glennji/ibm-jx-5511-pc/dDSC_1564.jpg

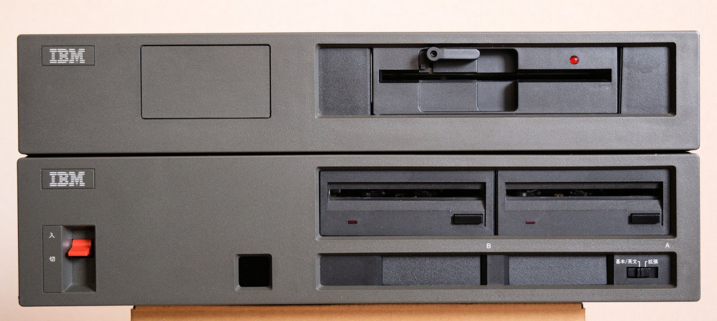
dDSC_1564.jpg
