glennji/ibm-jx-5511-pc/preview_dvd_fascia.png

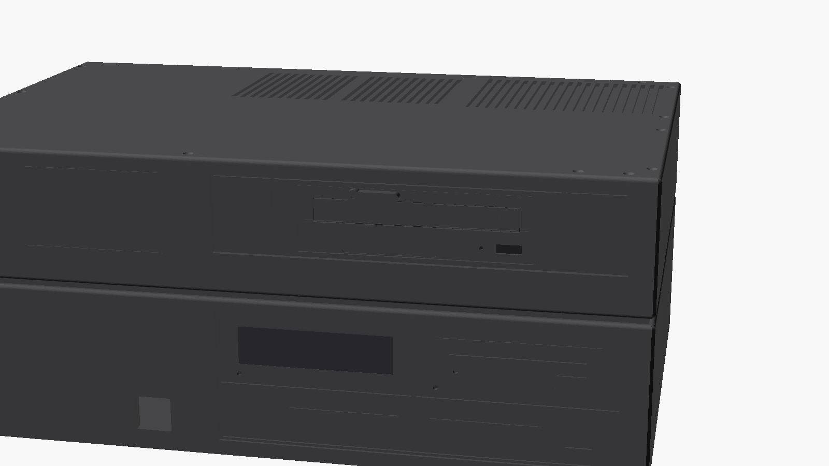
preview_dvd_fascia.png
