glennji/ibm-jx-5511-pc/preview_front.png

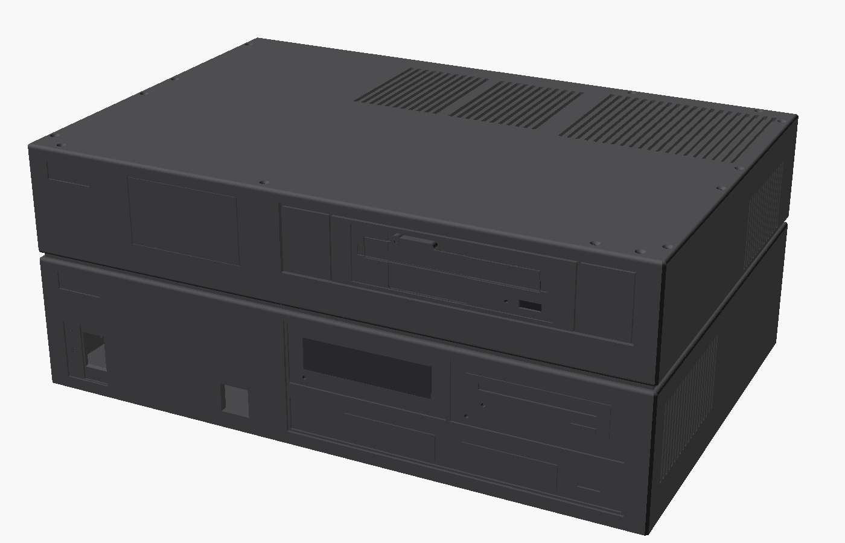
preview_front.png
