glennji/ibm-jx-5511-pc/preview_front_flat.png

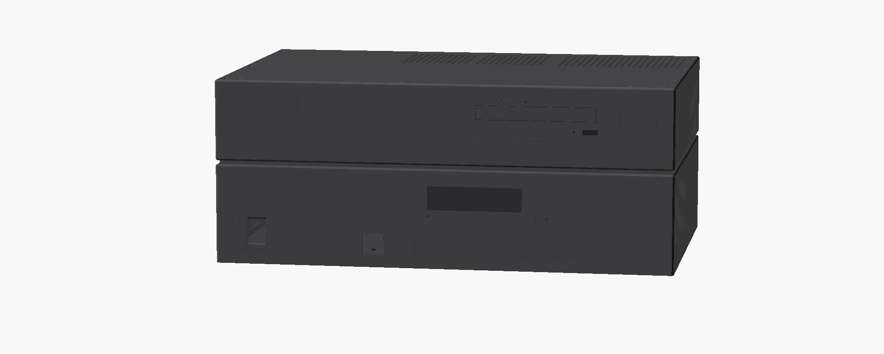
preview_front_flat.png
