glennji/ibm-jx-5511-pc/preview_labels_all.png

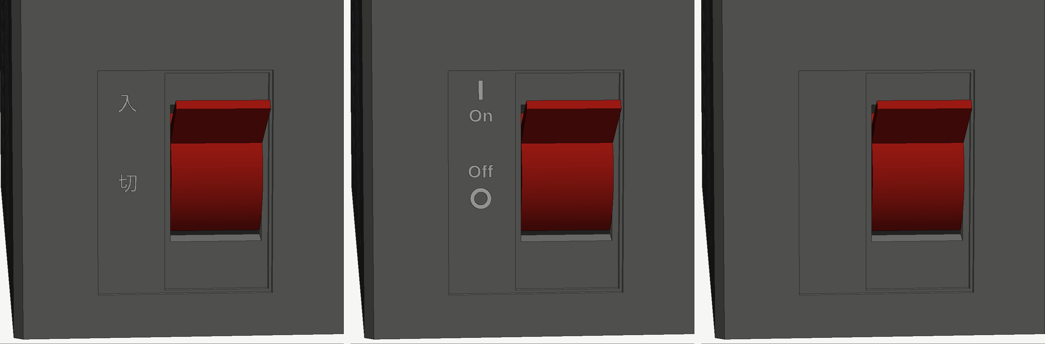
preview_labels_all.png
