glennji/ibm-jx-5511-pc/preview_labels_BLANK.png

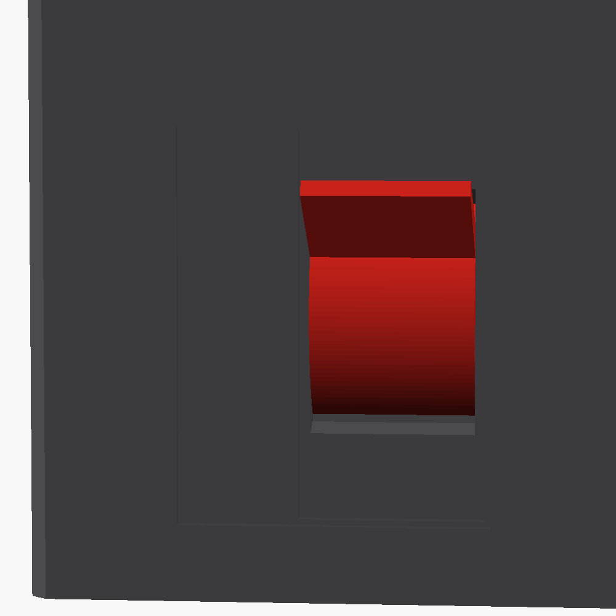
preview_labels_BLANK.png
