glennji/ibm-jx-5511-pc/preview_labels_EN.png

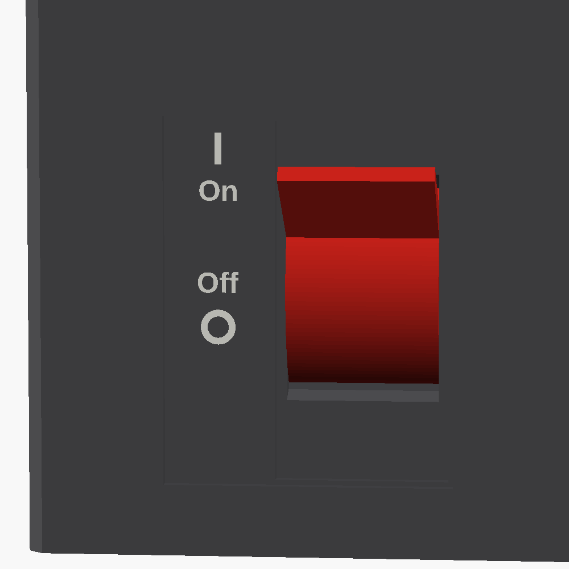
preview_labels_EN.png
