glennji/ibm-jx-5511-pc/preview_open.png

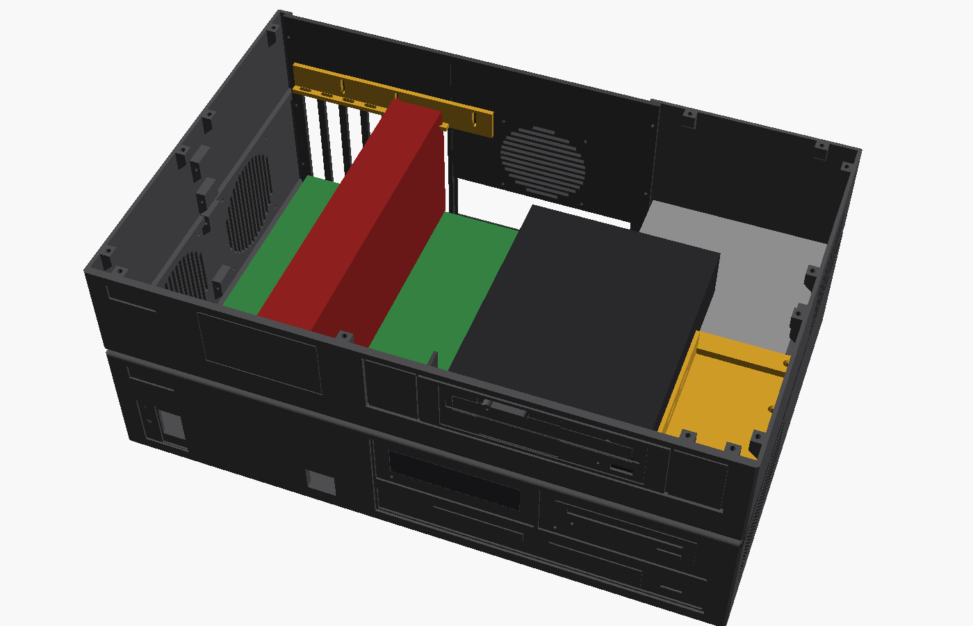
preview_open.png
