glennji/ibm-jx-5511-pc/preview_power_front.png

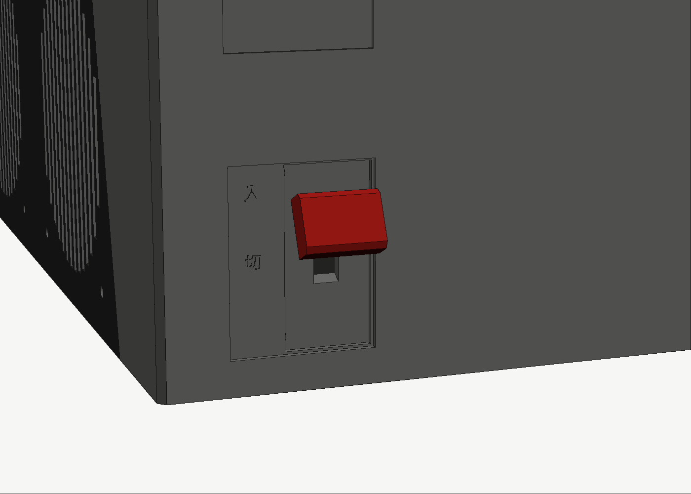
preview_power_front.png
