glennji/ibm-jx-5511-pc/preview_power_inside.png

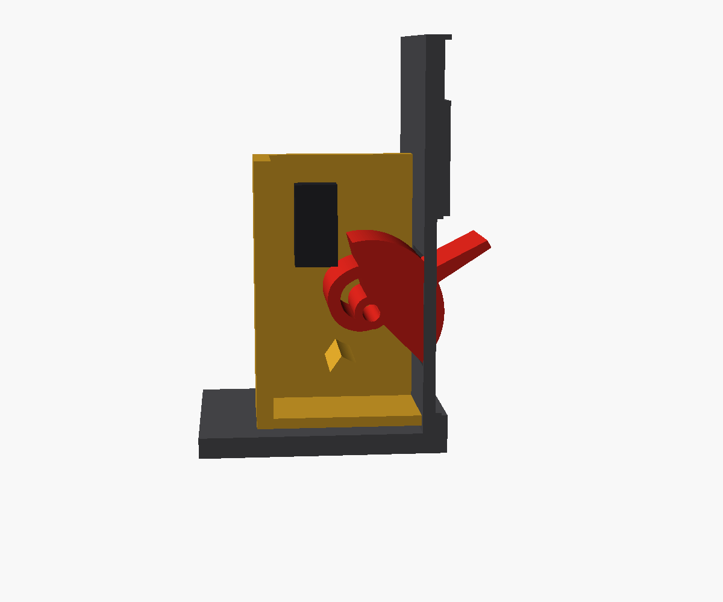
preview_power_inside.png
