glennji/ibm-jx-5511-pc/preview_power_off.png

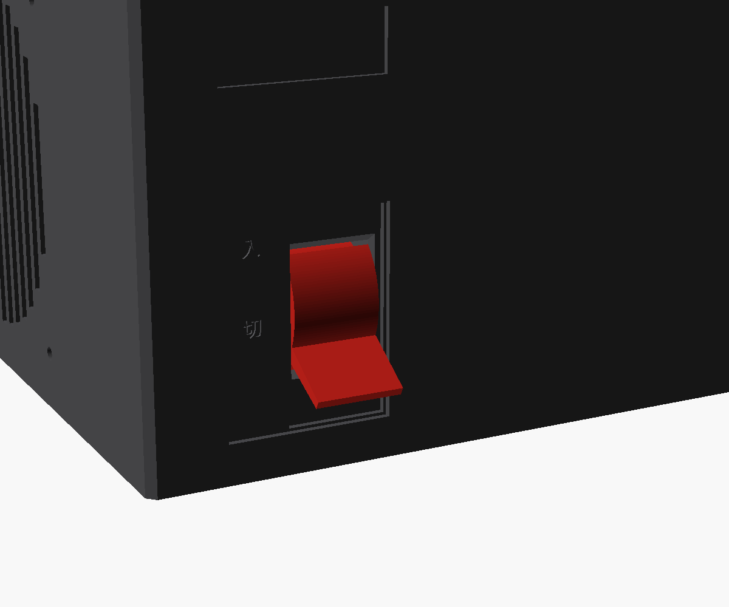
preview_power_off.png
