glennji/ibm-jx-5511-pc/preview_rear.png

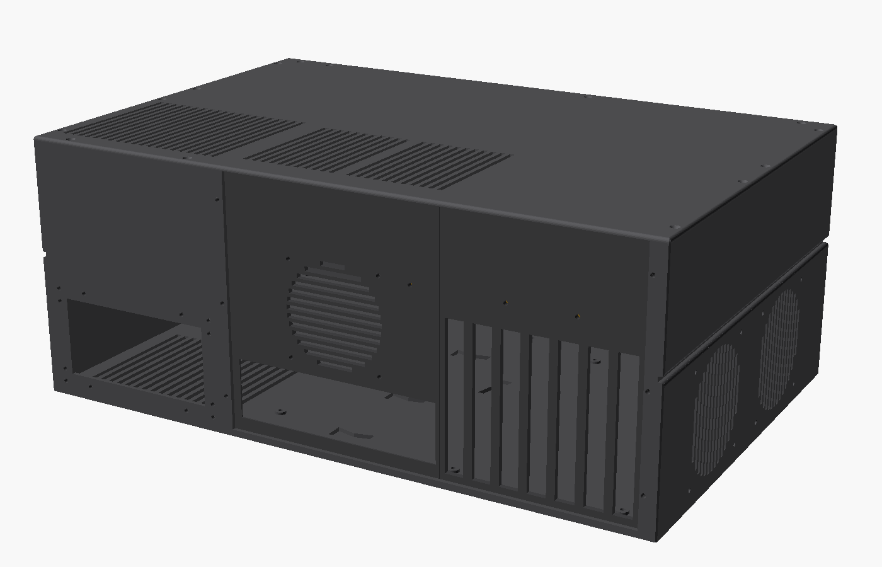
preview_rear.png
