glennji/ibm-jx-5511-pc/3mf/_assembly_open_preview.3mf

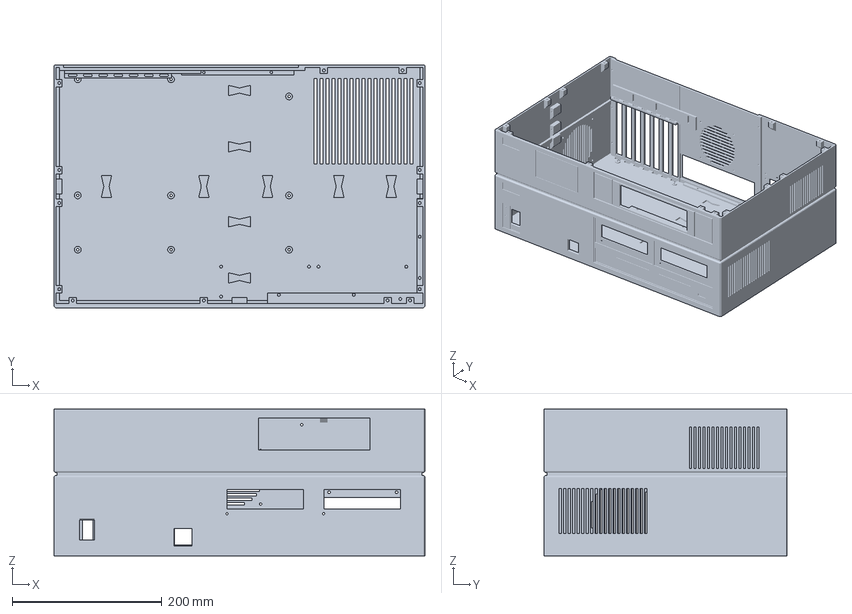
[picture p14: CAD file, 2026-11-01]
3mf/_assembly_open_preview.3mf
495.0 x 324.0 x 196.0 mm
