glennji/ibm-jx-5511-pc/3mf/rear_io_panel.3mf

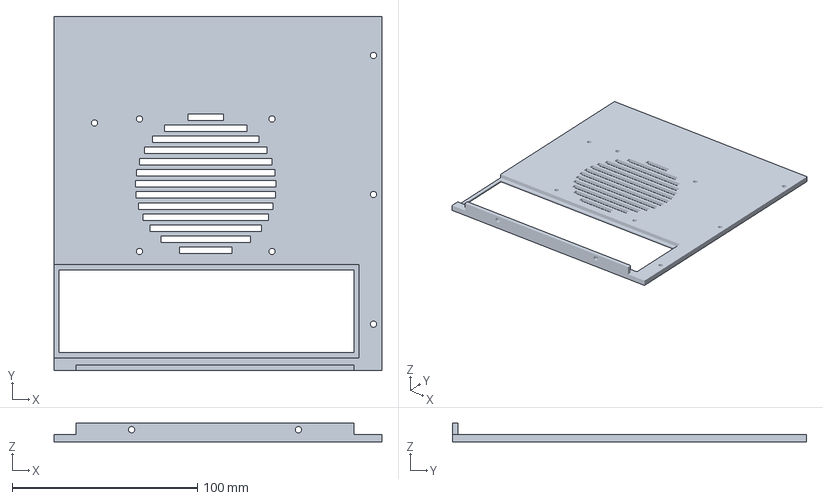
[picture p16: CAD file, 2026-11-01]
3mf/rear_io_panel.3mf
176.8 x 191.0 x 10.0 mm
