glennji/ibm-jx-5511-pc/3mf/lid_rear_right.3mf

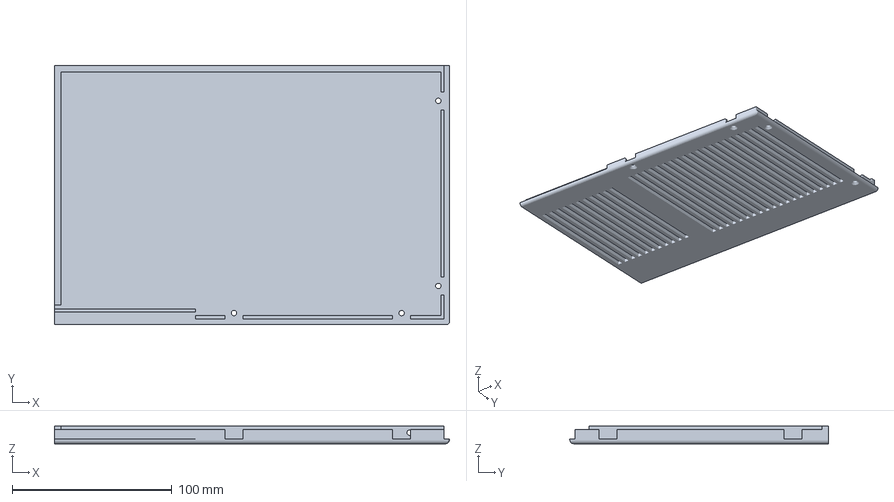
[picture p17: CAD file, 2026-11-01]
3mf/lid_rear_right.3mf
247.5 x 162.0 x 11.0 mm
