glennji/ibm-jx-5511-pc/3mf/dvd_fascia_tray.3mf

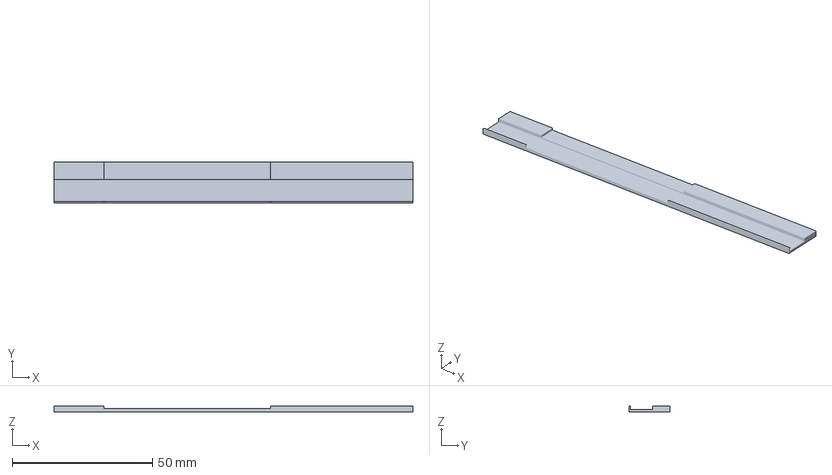
[picture p21: CAD file, 2026-11-01]
3mf/dvd_fascia_tray.3mf
128.0 x 14.5 x 2.00 mm
