glennji/ibm-jx-5511-pc/3mf/base_front_left_EN.3mf

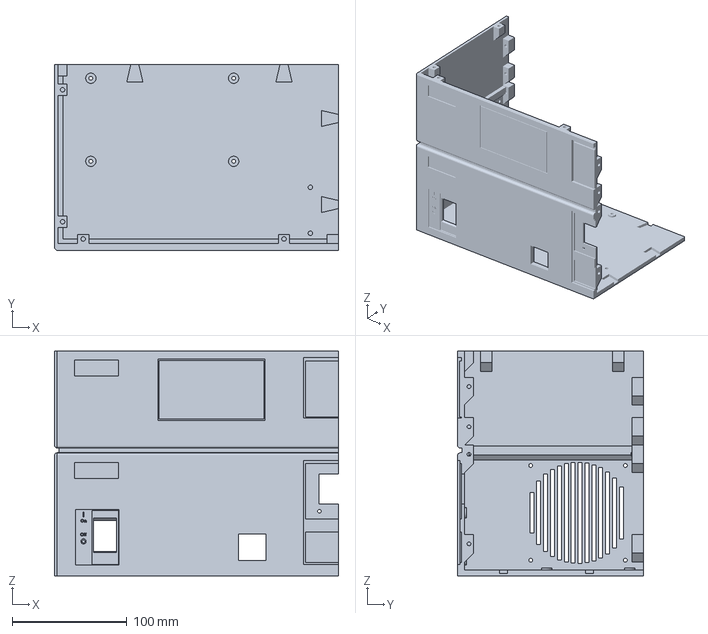
[picture p22: CAD file, 2026-11-01]
3mf/base_front_left_EN.3mf
247.5 x 162.0 x 196.0 mm
