glennji/ibm-jx-5511-pc/3mf/bay_blank_clip_x2.3mf

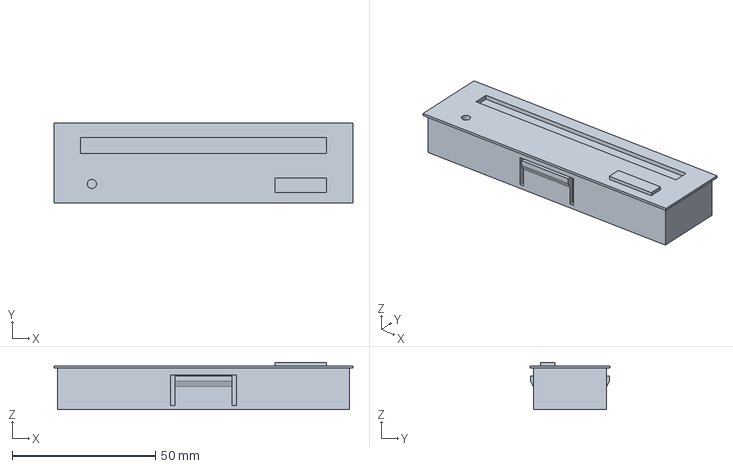
[picture p23: CAD file, 2026-11-01]
3mf/bay_blank_clip_x2.3mf
104.2 x 28.0 x 16.5 mm
