glennji/ibm-jx-5511-pc/3mf/fit_template_left.3mf

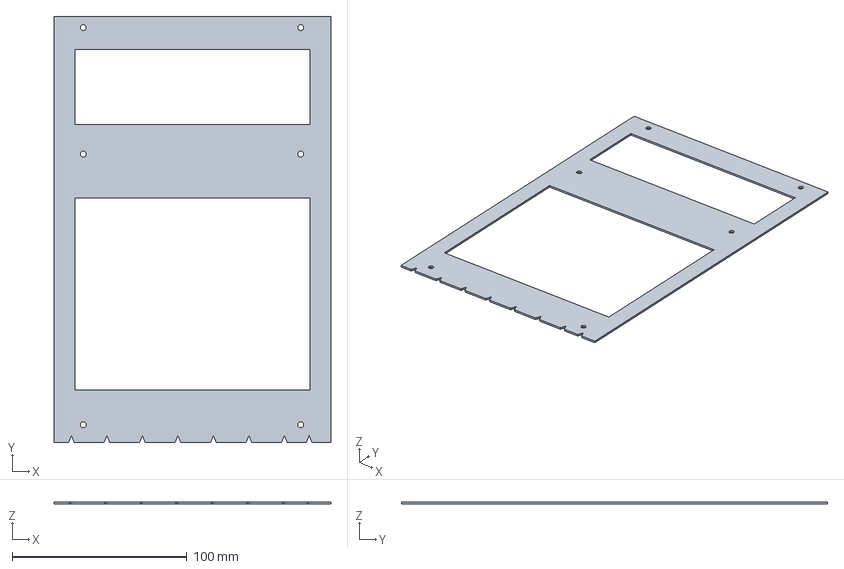
[picture p24: CAD file, 2026-11-01]
3mf/fit_template_left.3mf
158.4 x 243.8 x 1.20 mm
