glennji/ibm-jx-5511-pc/3mf/bay_cage_35_x2.3mf

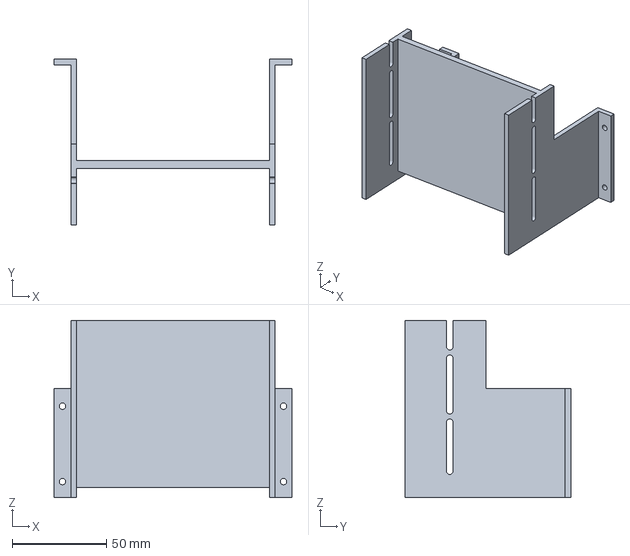
[picture p25: CAD file, 2026-11-01]
3mf/bay_cage_35_x2.3mf
126.2 x 87.9 x 94.0 mm
