glennji/ibm-jx-5511-pc/3mf/power_switch_frame.3mf

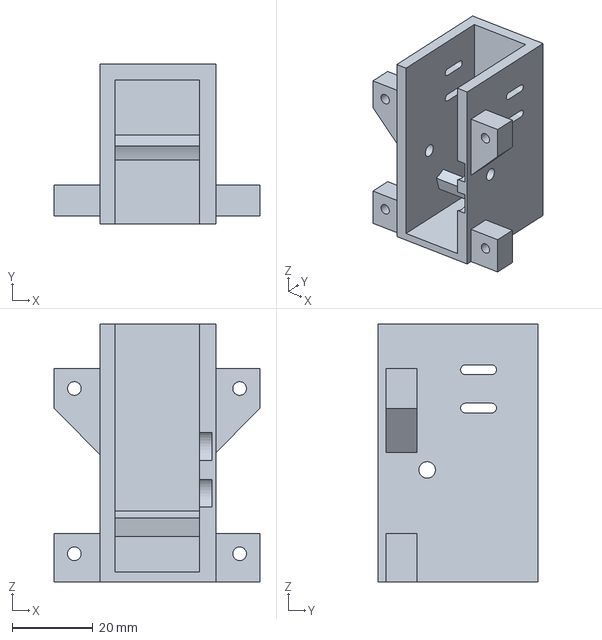
[picture p26: CAD file, 2026-11-01]
3mf/power_switch_frame.3mf
51.0 x 39.7 x 64.0 mm
