glennji/ibm-jx-5511-pc/3mf/foot_x6.3mf

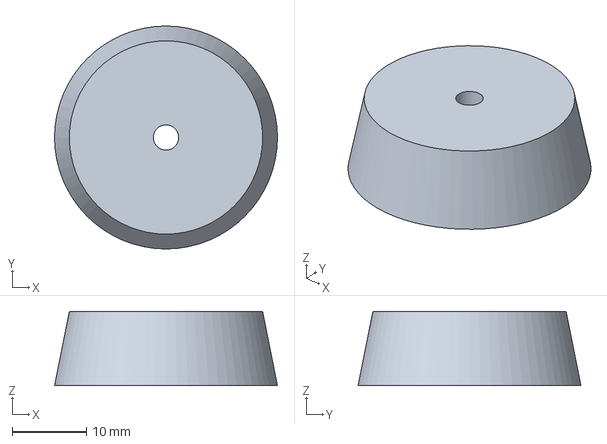
[picture p27: CAD file, 2026-11-01]
3mf/foot_x6.3mf
30.0 x 30.0 x 10.0 mm
