glennji/ibm-jx-5511-pc/3mf/rear_slot_panel.3mf

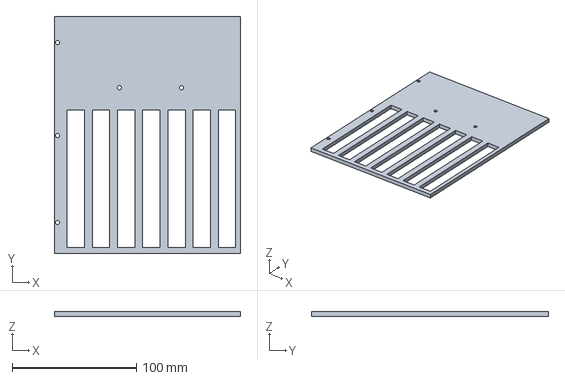
[picture p28: CAD file, 2026-11-01]
3mf/rear_slot_panel.3mf
150.2 x 191.0 x 4.00 mm
