glennji/ibm-jx-5511-pc/3mf/labels_JP_inlay.3mf

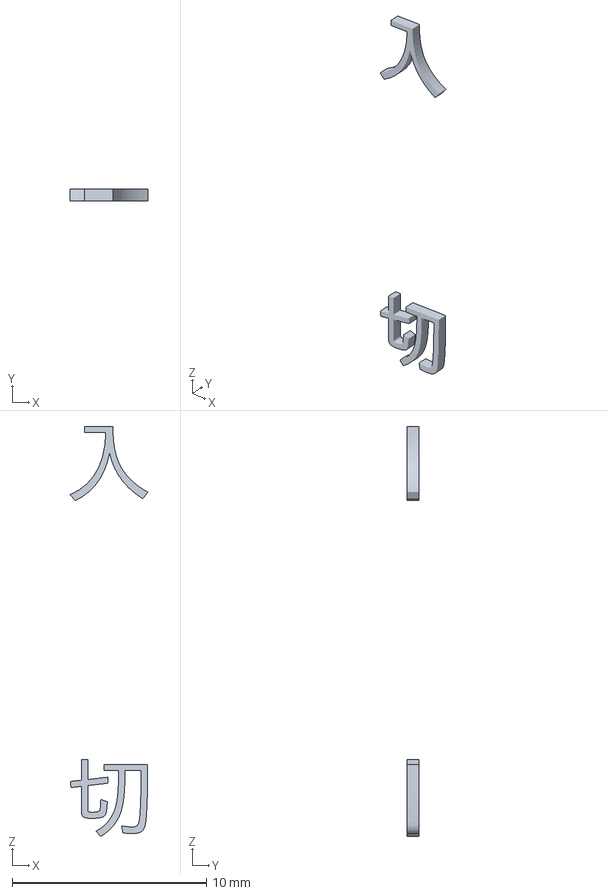
[picture p29: CAD file, 2026-11-01]
3mf/labels_JP_inlay.3mf
4.00 x 0.6 x 21.1 mm
