glennji/ibm-jx-5511-pc/3mf/butterfly_key_x9.3mf

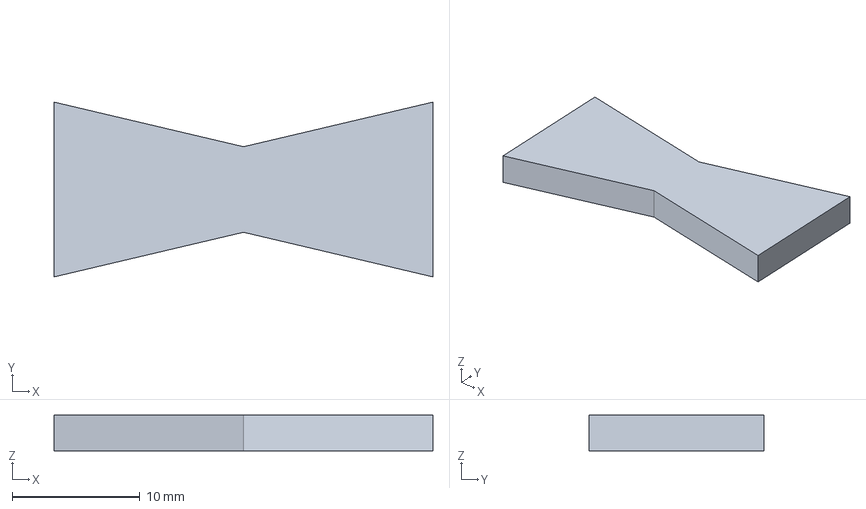
[picture p30: CAD file, 2026-11-01]
3mf/butterfly_key_x9.3mf
29.7 x 13.7 x 2.80 mm
