glennji/ibm-jx-5511-pc/3mf/labels_EN_inlay.3mf

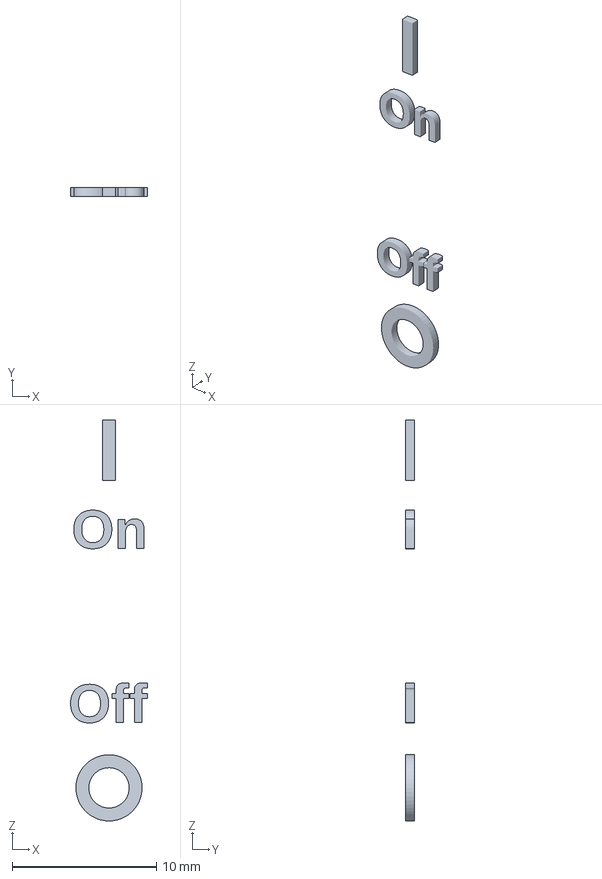
[picture p31: CAD file, 2026-11-01]
3mf/labels_EN_inlay.3mf
5.34 x 0.6 x 27.8 mm
