glennji/ibm-jx-5511-pc/3mf/lid_front_left.3mf

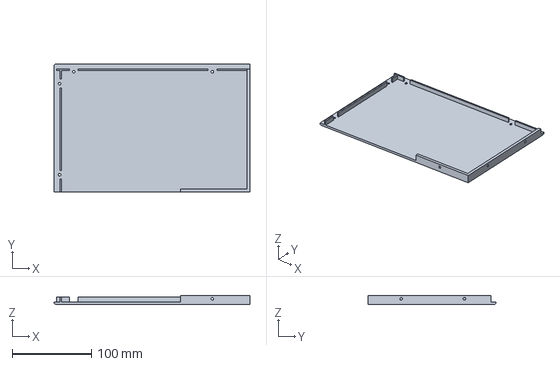
[picture p32: CAD file, 2026-11-01]
3mf/lid_front_left.3mf
247.5 x 162.0 x 11.0 mm
