glennji/ibm-jx-5511-pc/3mf/dvd_fascia_frame.3mf

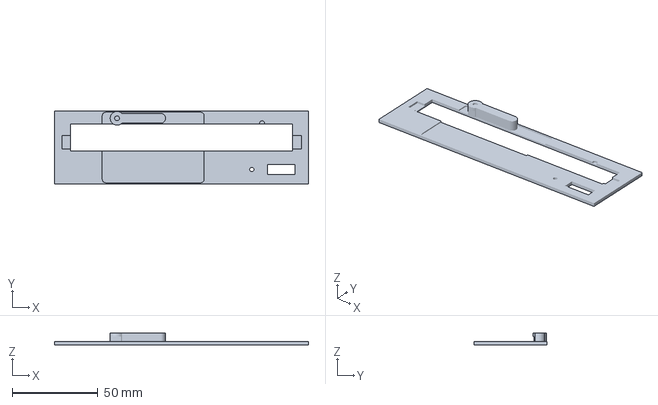
[picture p33: CAD file, 2026-11-01]
3mf/dvd_fascia_frame.3mf
148.0 x 42.3 x 7.00 mm
