glennji/ibm-jx-5511-pc/3mf/badge_plate_x2.3mf

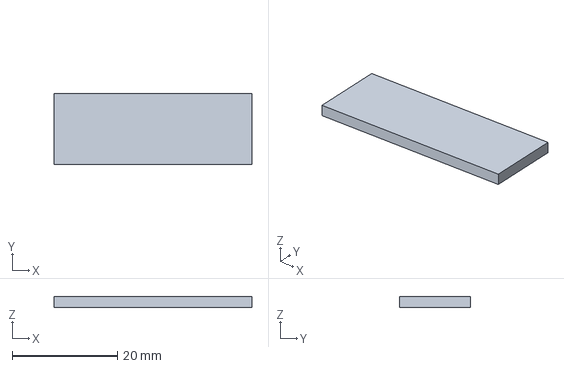
[picture p34: CAD file, 2026-11-01]
3mf/badge_plate_x2.3mf
37.7 x 13.6 x 2.00 mm
