glennji/ibm-jx-5511-pc/3mf/bracket_rail.3mf

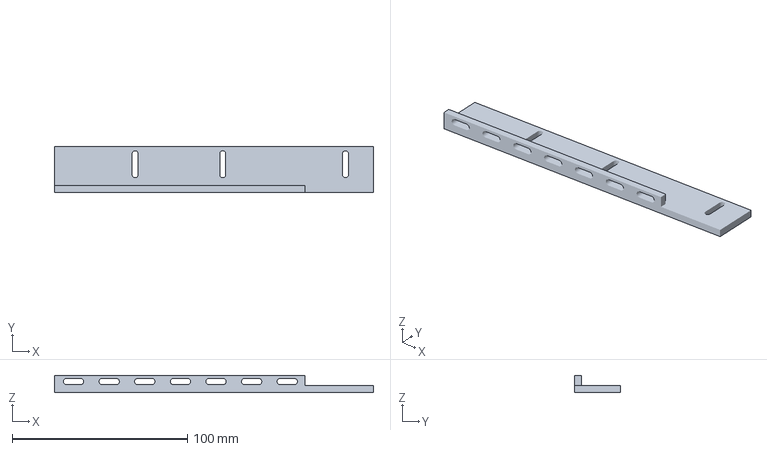
[picture p36: CAD file, 2026-11-01]
3mf/bracket_rail.3mf
182.0 x 26.0 x 9.80 mm
