glennji/ibm-jx-5511-pc/3mf/dvd_shelf.3mf

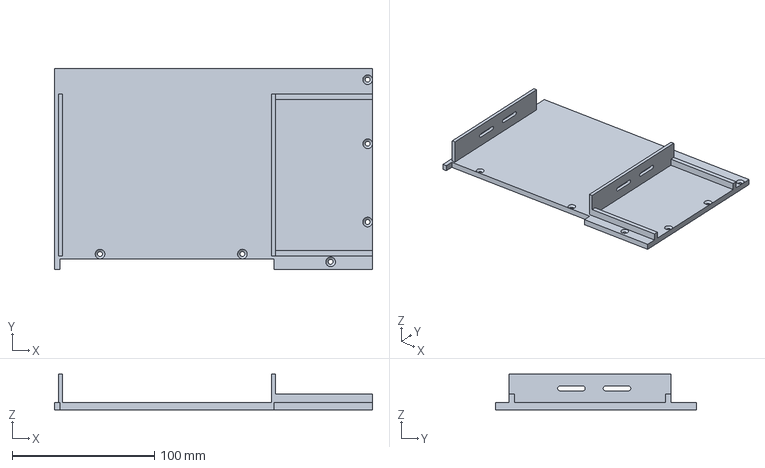
[picture p38: CAD file, 2026-11-01]
3mf/dvd_shelf.3mf
223.4 x 141.5 x 25.0 mm
