glennji/ibm-jx-5511-pc/(list of files, cad)

Other CAD files:
3mf/base_front_left_JP.3mf
3mf/base_front_left_BLANK.3mf
3mf/fit_template_right.3mf
stl/_assembly_open_preview.stl
stl/_assembly_preview.stl
stl/badge_plate_x2.stl
stl/base_front_left_BLANK.stl
stl/base_front_left_EN.stl
stl/base_front_left_JP.stl
stl/base_front_right.stl
stl/base_rear_left.stl
stl/base_rear_right.stl
stl/bay_blank_clip_x2.stl
stl/bay_cage_35_x2.stl
stl/bracket_rail.stl
stl/butterfly_key_x9.stl
stl/dvd_fascia_frame.stl
stl/dvd_fascia_tray.stl
stl/dvd_shelf.stl
stl/fit_template_left.stl
stl/fit_template_right.stl
stl/foot_x6.stl
stl/labels_EN_inlay.stl
stl/labels_JP_inlay.stl
stl/lid_front_left.stl
stl/lid_front_right.stl
stl/lid_rear_left.stl
stl/lid_rear_right.stl
stl/power_switch_frame.stl
stl/rear_io_panel.stl
stl/rear_slot_panel.stl
