glennji/ibm-jx-5511-pc/(commit log)

2026-10-18 feat: initial commit
    Printable case for LARPing as an IBM JX 5511 owner i.e. nostalgia level
    9. Still very much a work in progress, but I'm going to go order some
    charcoal PETG!
    [_assembly_preview.stl, badge_plate_x2.stl, base_front_left.stl, base_front_right.stl, base_rear_left.stl, base_rear_right.stl, bracket_rail.stl, butterfly_key_x9.stl]
2026-10-20 Tweaks
    Adjust ratio and groove depth to make it closer to the JX stack. Make
    the drive-slots functional.
    [_assembly_preview.stl, badge_plate_x2.stl, base_front_left.stl, base_front_right.stl, base_rear_left.stl, base_rear_right.stl, bay_blank_clip_x2.stl, bay_cage_35_x2.stl]
2026-10-26 Openscad (#1)
    * Port the case model to OpenSCAD
    jx_case.scad replaces jx_case.py, converted line for line; every part
    matches the previous STLs in volume and bounding box. build.py renders
    the parts and drops them onto the bed, fitcheck.py checks clearances as
    OpenSCAD intersections, and render.py exports previews from the scenes
    in render.scad. The scripts need only the Python standard library.
    Label parts are not written when the label font is missing, since a
    fallback font can cut missing-glyph boxes into the face. Previews use a
    charcoal case colour (CASE_COLOUR in render.scad).
    * Remove STLs left over from earlier designs
    * Round the lid's top edge and the groove lips
    The lid's top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
    [_assembly_open_preview.stl, _assembly_preview.stl, badge_plate_x2.stl, base_front_left.stl, base_front_left_BLANK.stl, base_front_left_EN.stl, base_front_left_JP.stl, base_front_right.stl]
2026-11-01 Add 3MF export and support the OpenSCAD snapshot AppImage (#2)
    * Add 3MF export and support the OpenSCAD snapshot AppImage
    - build.py --3mf writes every part as 3MF into ./3mf (same bed placement,
    label-inlay pairing and size report as the STL build). The writer is in
    scadtools.write_3mf and uses only the standard library.
    - Add the generated 3mf/ files alongside stl/.
    - Older OpenSCAD snapshots, including the official AppImage
    (AUR openscad-snapshot-appimage), still gate textmetrics() behind
    --enable=textmetrics. scadtools now passes the flag when the binary
    lists it, so the build works with both the AppImage and current master.
    - README: document --3mf, the 3mf/ folder and the A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
    [_assembly_open_preview.3mf, _assembly_preview.3mf, badge_plate_x2.3mf, base_front_left_BLANK.3mf, base_front_left_EN.3mf, base_front_left_JP.3mf, base_front_right.3mf, base_rear_left.3mf]
